0-Mousa-0/DUSK-1/docs/assets/dashboard-camera.png

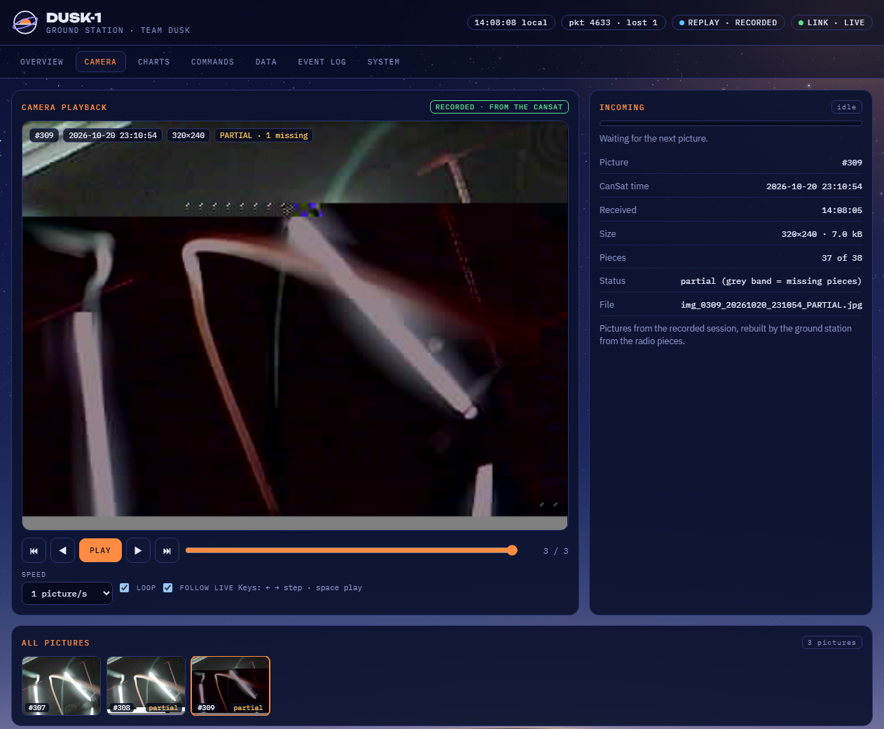
docs/assets/dashboard-camera.png
