0-Mousa-0/DUSK-1/docs/assets/dashboard-public-readonly.png

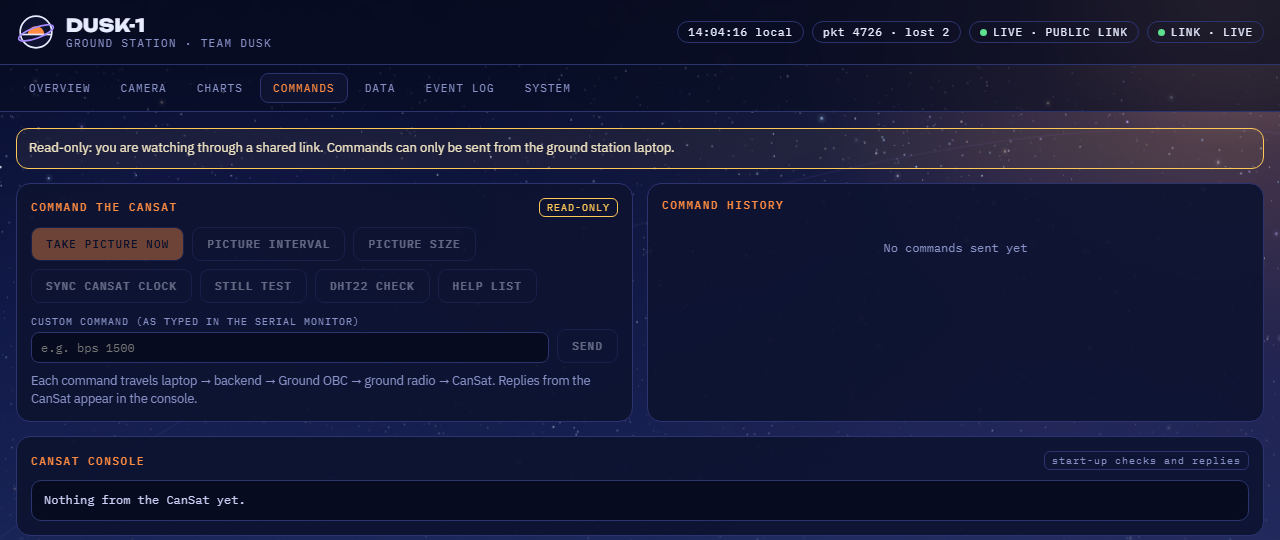
docs/assets/dashboard-public-readonly.png
